IvanNieto5280/ME507/ChessRobotArm_FinalizedCode/Core/README.md

@mainpage Chess Robot Arm Documentation

@section authors Authors

Ivan Nieto

Reynaldo Farias

@section overview Project Overview

The purpose of the chess robot arm was to be able to create an electromechanical system that could pick up chess pieces and be able to move them around a chess board by joystick manipulation of a user. 

\htmlonly
<a href="https://youtube.com/shorts/9AqLv6E1KCE" target="_blank">
  
</a>
<br>
<em>Click image to watch the chess robot demo video.</em>
\endhtmlonly

@section hardware Major Hardware

- Three Stepper motors

- Servo-based gripper

- Two Joysticks

- Emergency stop

@section software Software Implementation

-  Serial Perpherial Interface (SPI)

- Serial Wire Debug (SWD)

- Universal Synchronous Asynchronous Reciever-Transmitter (USART)

@section pcb PCB Design

<div align="left">
    
    <br>
    <em>Figure 1. PCB with connected wiring.</em>
</div>

@section wire Wire Harnessing

@section future Future Work
