IvanNieto5280/ME507/Chess Robot Arm Electronics Design Memorandum.pdf

Chess Robot Arm: Electronics Design

To: | Charlie Revfem, Department of Mechanical Engineering, Cal Poly SLO
crefvem@calpoly.edu
From: | Reynaldo Farias RF
Ivan Nieto | IN
Date: | 5/17/2026

This memorandum accompanies the electronics design submission for the Chess Robot Arm. Included with this submission are the following items:

### 1. Fusion 360 electronics design export (.f3z)

### 2. Detailed bill of materials (BOM) including:

o Reference Designators
o Quanty
o Manufacturer/vendor part numbers
o Supplier links

### 3. Mechanical assembly drawing showing PCB integraon into the overall design

### 4. Updated high-level wiring diagram

The Chess Robot Arm consists of a Xbox-type controller which contains two modes, selected by moving a switch on the PCB; One to manually move the arm with joyscks, and the other to have the robot autonomously play chess with the user using a Raspberry Pi camera system. The first mode is the main goal of the project, while the second mode is the reach goal.
Please refer to the aached documentaon for detailed design informaon, component sourcing, and wiring specificaons.
