IvanNieto5280/ME507/docs/BlockDiagram.jpg

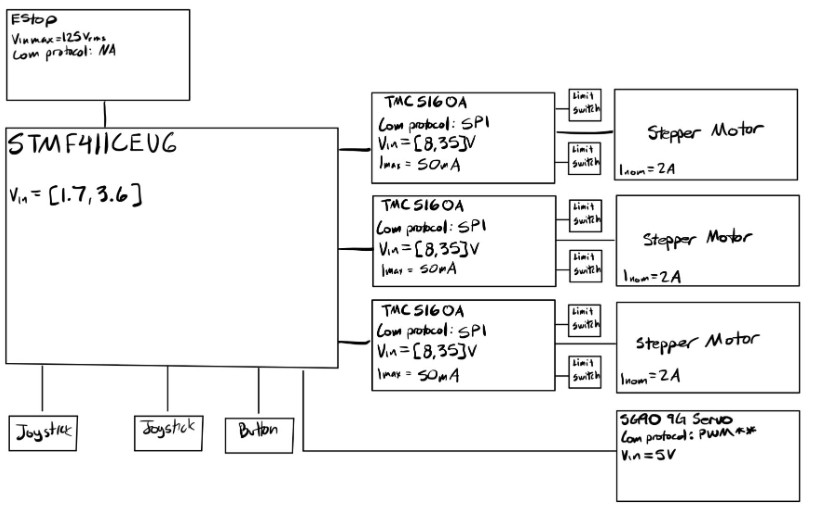
docs/BlockDiagram.jpg
