IvanNieto5280/ME507/docs/CR1.jpg

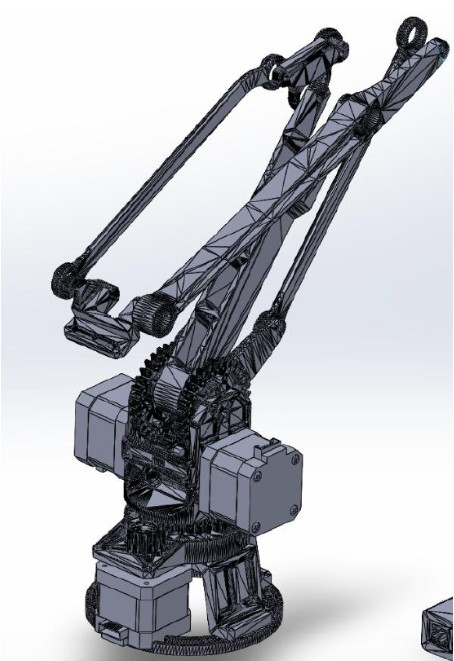
docs/CR1.jpg
