IvanNieto5280/ME507/docs/CR2.jpg

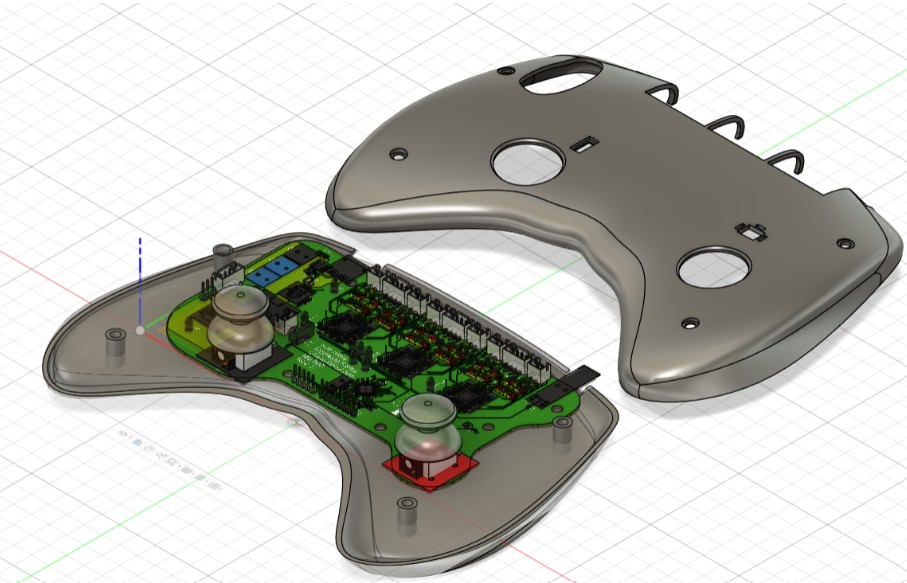
docs/CR2.jpg
