IvanNieto5280/ME507/docs/Rework.jpg

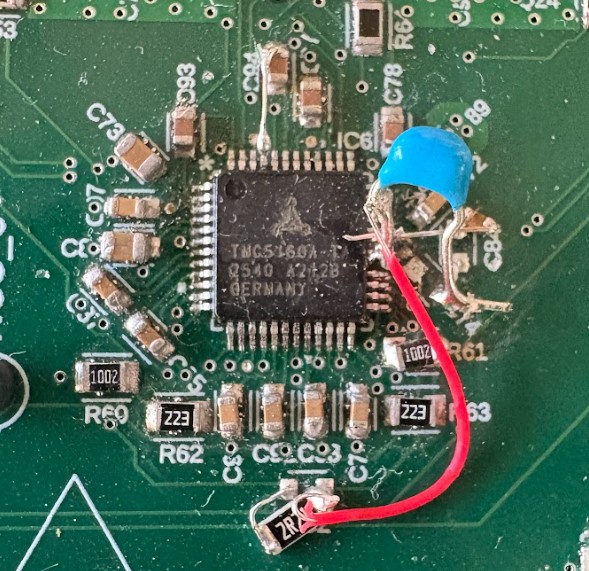
docs/Rework.jpg
