IvanNieto5280/ME507/Minimal MCU_ME507_Homework 3_BOM.pdf

Name | Minimal MCU_ME507_Homework 3 v11
Exported by | ivan.nieto5280@gmail.com
Time of Export | 4/19/2026 1:16 PM
Reference Designators | Quantity
| 1
C1, C2 | 2
C3, C9 | 2
C4, C5, C6, C7, C8, C10, C15 | 7
C12 | 1
C13 | 1
C14 | 1
C17, C18 | 2
CR1 | 1
D1 | 1
IC1 | 1
IC2 | 1
IC3 | 1
JP1 | 1
L1 | 1
Q1 | 1
R1 | 1
R2, R8 | 2
R3, R4 | 2
R5 | 1
R6 | 1
U$2 | 1
U$3 | 1
X1 | 1
Z1 | 1

Description
Board
Capacitor - Generic
Capacitor - Generic
Capacitor - Generic
Capacitor - Generic
Capacitor - Generic

Capacitor - Generic

Green LED - Generic

Pin Header

Resistor Fixed - Generic
Resistor Fixed - Generic
Resistor Fixed - Generic
Resistor Fixed - Generic
Resistor Fixed - Generic

250 mW Rating on FR-4 or FR-5 Board; Zener Breakdown Voltage Range - 2.4 V to 75 V; Package Designed for Optimal Automated Board Assembly; Small Package Size for High Density Applications; ESD Rating of Class 3 (>16 KV) per Human Body Model; Mechanical Characteristics:; CASE: Void-free, transfer-molded, thermosetting plastic case; FINISH: Corrosion resistant finish, easily solderable; MAXIMUM CASE TEMPERATURE FOR SOLDERING PURPOSES: 260C for 10 Seconds; POLARITY: Cathode indicated by polarity band; FLAMMAB

Package | Value | Manufacturer
Board
CAPC1608X85 | 10pF
CAPC1005X60 | 4.7uF
CAPC1005X60 | 0.1uF
CAPC3225X135 | 10uF
CAPC2012X110 | 10nF
PCAP_SVP_E7_PAN-L | 390uF
CAPC1005X60 | 1uF
DPAK_Q04FN-M3_VIS | VS-50WQ04FN-M3DPAK_Q04FN-M3_VIS
LEDC3216X75N_FLAT-G | CHIP-FLAT-G_1206
QFN50P700X700X60-49T559 | STM32F411CEU6
DDA8_3P1X2P4-L | TPS5450DDARDDA8_3P1X2P4-L
FP-NCP164CSN330T1G_OSI | NCP164CSN330T1GFP-NCP164CSN330T1G_OSI
1X08 | PINHD-1X8
DR127 | DR127-100-RDR127
TRANS_TSM150P04LCS_RLG | TSM150P04LCS_RLG | Taiwan Semiconductor
RESC1608X60 | 10k
RESC1608X60 | 1k
RESC1608X60 | 0.005
RESC2012X65 | 10k
RESC2012X65 | 3.16k
XTALRR488W43L1097T465H360 FOXSLF/080-20
PTS636SM43SMTRLFS | PTS636SM43SMTRLFSSWITCH
XT30PW-M | XT30PW-M
SOT96P237X111-3N | BZX84C15LT1G

Manufacturer Part Number Vendor Vendor Part Number Top/Bottom

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
