IvanNieto5280/ME507/Chess Robot Final BOM.xlsx

Reference Designators | Quantity | Manufacturer Part Number | Package | Value | Link
C1, C2 | 2 | GCM1885C2A300FA16D | CAPC1608X85 | 30pF | https://www.digikey.com/en/products/detail/murata-electronics/GCM1885C2A300FA16D/17845360
C3, C9, C23, C38, C49, C65, C76, C92 | 8 | TMK212AB7475KG-T | CAPC2012X110 | 4.7uF | https://www.digikey.com/en/products/detail/taiyo-yuden/TMK212AB7475KG-T/2714168
C4, C5, C6, C7, C8, C10, C16, C22, C32, C34, C35, C36, C37, C42, C43, C44, C45, C48, C59, C61, C62, C63, C64, C69, C70, C71, C72, C75, C86, C88, C89, C90, C91, C96, C97, C98 | 36 | C0603C104K5RACTU | CAPC1608X85 | 0.1uF | https://www.digikey.com/en/products/detail/kemet/C0603C104K5RACTU/1465594
C11 | 1 | C0603C104K5RACTU | CAPC1608X85 | 100nF | https://www.digikey.com/en/products/detail/kemet/C0603C104K5RACTU/1465594
C12 | 1 | CL32B106KMVNNWE | CAPC3225X135 | 10uF | https://www.digikey.com/en/products/detail/samsung-electro-mechanics/CL32B106KMVNNWE/7320558
C13 | 1 | CL21B103KBANNNC | CAPC2012X110 | 10nF | https://www.digikey.com/en/products/detail/samsung-electro-mechanics/CL21B103KBANNNC/3886673
C14 | 1 | 6SVPC390M | PCAP_SVP_E7_PAN-L | 390uF | https://www.digikey.com/en/products/detail/panasonic-industry/6SVPC390M/4204944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
C15 | 1 | GCM155R71H104KE02J | CAPC1005X60 | 0.1uF | https://www.digikey.com/en/products/detail/murata-electronics/GCM155R71H104KE02J/4903705
C17, C18 | 2 | GRM155Z71A105KE01D | CAPC1005X60 | 1uF | https://www.digikey.com/en/products/detail/murata-electronics/GRM155Z71A105KE01D/13905035
C19, C20, C46, C56, C73, C83 | 6 | CL21A475KAQNNNE | CAPC1608X85 | 4.7uF | https://www.digikey.com/en/products/detail/samsung-electro-mechanics/CL21A475KAQNNNE/3886902
C21, C24, C25, C39, C40, C47, C50, C51, C66, C67, C74, C77, C78, C93, C94 | 15 | KAM15BR71E474KT | CAPC1608X85 | 0.47uF | https://www.digikey.com/en/products/detail/kyocera-avx/KAM15BR71E474KT/27152850
C26, C27, C28, C29, C52, C53, C54, C55, C79, C80, C81, C82 | 12 | CL21B102KCANNNC | CAPC2012X110 | 1nF | https://www.digikey.com/en/products/detail/samsung-electro-mechanics/CL21B102KCANNNC/3886827
C30, C57, C84 | 3 | C0603C223K1RACTU | CAPC1608X85 | 22nF | https://www.digikey.com/en/products/detail/kemet/C0603C223K1RACTU/754738
C31, C58, C85 | 3 | EGXF101ELL201MK25S | CAPPRD500W65D1025H2500 | CAP_ALUM | https://www.digikey.com/en/products/detail/chemi-con/EGXF101ELL201MK25S/6204522
C33, C41, C60, C68, C87, C95 | 6 | C0603C222K4RECAUTO | CAPC1608X85 | 2.2nF | https://www.digikey.com/en/products/detail/kemet/C0603C222K4RECAUTO/8646528
C99 | 1 | 860040573004 | WCAP-ATUL_6.3X11(DXL) | WCAP-ATUL_6.3X11 | https://www.digikey.com/en/products/detail/w%C3%BCrth-elektronik/860040573004/5727450
D1, D3 | 2 | LTST-C150GKT | LEDC3216X75N_FLAT-G | CHIP-FLAT-G_1206 | https://www.digikey.com/en/products/detail/liteon/LTST-C150GKT/269216
D2 | 1 | VS-50WQ04FN-M3 | DPAK_Q04FN-M3_VIS-M | VS50WQ04FNM3 | https://www.digikey.com/en/products/detail/vishay-general-semiconductor-diodes-division/VS-50WQ04FN-M3/4934503
DGND, MISO, MOSI, NCS_1, NCS_2, NCS_3, PGND, SCK, VOGND | 9 | Popular Test Points | TP-KEYSTONE-COMPACT | TP_5005_COMPACT | https://www.digikey.com/en/products/detail/keystone-electronics/5000/255326?gclsrc=aw.ds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
FB1 | 1 | BLM18PG121SN1D | BEADC1608X95N | FBCHIP-0603(1608-METRIC) | https://www.digikey.com/en/products/detail/murata-electronics/BLM18PG121SN1D/584248
IC1 | 1 | STM32F411CEU6 | QFN50P700X700X60-49T559 | STM32F411CEU6 | https://www.digikey.com/en/products/detail/stmicroelectronics/STM32F411CEU6/4935720
IC2 | 1 | TPS54531DDAR | DDA8_3P1X2P4-L | TPS5450DDARDDA8_3P1X2P4-L | https://www.digikey.com/en/products/detail/texas-instruments/TPS54531DDAR/4162425
IC3 | 1 | NCP164CSN330T1G | FP-NCP164CSN330T1G_OSI | NCP164CSN330T1GFP-NCP164CSN330T1G_OSI | https://www.digikey.com/en/products/detail/onsemi/NCP164CSN330T1G/11592854
IC4, IC5, IC6 | 3 | TMC5160A-TA-T | 21-100582_ADI-L | TMC5160A-TA-T21-100582_ADI-L | https://www.digikey.com/en/products/detail/analog-devices-inc-maxim-integrated/TMC5160A-TA-T/11306900
J1, J4, J6, J9 | 4 | XH Connector Top Entry - 4POS | B4B-XH-A | B4B-XH-A | https://www.digikey.com/en/products/detail/jst-sales-america-inc/B4B-XH-A/1651047
J2, J3, J5, J7, J8, J10, J11 | 7 | B2B-XH-A | B2B-XH-A | B2B-XH-A | https://www.digikey.com/en/products/detail/jst-sales-america-inc/B2B-XH-A/1651045
Insert to above | 7 | XHP-2 |  |  | https://www.digikey.com/en/products/detail/jst-sales-america-inc/XHP-2/555485
JP1 | 1 | 61300311121 | 1X08 | PINHD-1X8 | https://www.digikey.com/en/products/detail/w%C3%BCrth-elektronik/61300311121/4846825
JS1, JS2 | 2 | 9032 | XDCR_COM-09032 | COM-09032 | https://www.digikey.com/en/products/detail/sparkfun-electronics/09032/6823623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
L1 | 1 | SRR1260-100M | DR127 | DR127-100-RDR127 | https://www.digikey.com/en/products/detail/bourns-inc/SRR1260-100M/1969954
PG | 1 | Test Pad | TP127R | TPSQTP127R | NA
Q1 | 1 | TSM150P04LCS RLG | TRANS_TSM150P04LCS_RLG | TSM150P04LCS_RLG | https://www.digikey.com/en/products/detail/taiwan-semiconductor-corporation/TSM150P04LCS-RLG/7360154
Q2, Q3, Q4, Q5, Q6, Q7, Q8, Q9, Q10, Q11, Q12, Q13, Q14, Q15, Q16, Q17, Q18, Q19, Q20, Q21, Q22, Q23, Q24, Q25 | 24 | RQ5L045BGTCL | SOT-346T | RQ5L045BG | https://www.digikey.com/en/products/detail/rohm-semiconductor/RQ5L045BGTCL/22602123
R1, R4, R9, R18, R30, R71 | 6 | RC0603FR-0710KL | RESC1608X60 | 10k | https://www.digikey.com/en/products/detail/yageo/RC0603FR-0710KL/726880
R2, R3 | 2 | ERJ-PA3J512V | RESC1608X60 | 5.1k | https://www.digikey.com/en/products/detail/panasonic-industry/ERJ-PA3J512V/5036073
R5, R19, R20, R41, R42, R60, R61 | 7 | RMCF0805FT10K0 | RESC2012X65 | 10k | https://www.digikey.com/en/products/detail/stackpole-electronics-inc/RMCF0805FT10K0/1760676
R6 | 1 | RC0603FR-073K16L | RESC2012X65 | 3.16k | https://www.digikey.com/en/products/detail/yageo/RC0603FR-073K16L/727124
R7 | 1 | RC0603FR-0747KL | RESC1608X60 | 47k | https://www.digikey.com/en/products/detail/yageo/RC0603FR-0747KL/727253
R8 | 1 | RC0603FR-07665RL | RESC1608X60 | 665 | https://www.digikey.com/en/products/detail/yageo/RC0603FR-07665RL/727349
R10, R33, R52 | 3 | RMCF1206FT2R21 | RESC1608X60 | 2.2 | https://www.digikey.com/en/products/detail/stackpole-electronics-inc/RMCF1206FT2R21/1758756
R11, R12, R13, R14, R23, R24, R25, R26, R34, R35, R36, R37, R45, R46, R47, R48, R53, R54, R55, R56, R64, R65, R66, R67 | 24 | CRCW080510R0FKEA | RESC2012X65 | 10 | https://www.digikey.sg/en/products/detail/vishay-dale/CRCW080510R0FKEA/1175409
R15, R27, R38, R49, R57, R68 | 6 | MFHA1206R1500FC | RESC3216X70 | 0.15 | https://www.digikey.com/en/products/detail/eaton-electronics-division/MFHA1206R1500FC/16713120
R16, R17, R28, R29, R39, R40, R50, R51, R58, R59, R69, R70 | 12 | RC0603FR-0747RL | RESC1608X60 | 47 | https://www.digikey.com/en/products/detail/yageo/RC0603FR-0747RL/727252
R21, R22, R43, R44, R62, R63 | 6 | RC0805JR-0722KL | RESC2012X65 | 22k | https://www.digikey.com/en/products/detail/yageo/RC0805JR-0722KL/728286
R31, R32 | 2 | ERA-6AEB472V | RESC1608X60 | 4.7k | https://www.digikey.com/en/products/detail/panasonic-industry/ERA-6AEB472V/1465765
S1 | 1 | DS01-254-L-01BE | DS-01 | DS01 | https://www.digikey.com/en/products/detail/same-sky-formerly-cui-devices/DS01-254-L-01BE/11310875
S2 | 1 | PB400OAQR1BLK | SW_PB400OAQR1BLK | PB400OAQR1BLK | https://www.digikey.com/en/products/detail/e-switch/PB400OAQR1BLK/8042727
S3 | 1 | B3U-1000P | B3U-1000P(M) | B3U-X000B3U-1000P(M)1000P(M) | https://www.digikey.com/en/products/detail/omron-electronics-inc-emc-div/B3U-1000P/1534338?gclsrc=aw.ds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
SERVO_PWM | 1 | 61300311121 | 1X03 | SERVOSG90-HDR | https://www.digikey.com/en/products/detail/w%C3%BCrth-elektronik/61300311121/4846825
U$1 | 1 | FC4STCBMF8.0 | XTALRR488W43L1097T465H360 | FOXSLF/080-20 | https://www.digikey.com/en/products/detail/fox-electronics/FC4STCBMF8-0/1024692
U$2 | 1 | 61300311121 | 1X05 | PINHD-1X05_1X05M | https://www.digikey.com/en/products/detail/w%C3%BCrth-elektronik/61300311121/4846825
U$3 | 1 | PTS636SM43SMTR LFS | PTS636SM43SMTRLFS | PTS636SM43SMTRLFSSWITCH | https://www.digikey.com/en/products/detail/c-k/PTS636SM43SMTR-LFS/10071723
X1 | 1 | XT30PW-M | XT30PW-M | XT30PW-M | https://www.amazon.com/XT30PW-Upgrade-Female-Connectors-Battery/dp/B0DM19KN2Y
Z1 | 1 | BZX84C15LT1G | SOT96P237X111-3N | BZX84C15LT1G | https://www.digikey.com/en/products/detail/onsemi/BZX84C15LT1G/918390
Stepper motor wires |  |  |  |  | https://www.amazon.com/Matugajp-0-2mm%C2%B2-Electrical-Extension-Stranded/dp/B0B943J4PG
Limit Switch Wires |  |  |  |  | https://www.amazon.com/AWG-Gauge-Electrical-Wire-Oxygen-Free/dp/B0FCM6L2DJ?sp_csd=d2lkZ2V0TmFtZT1zcF9hdGY
Limit Switches |  | D2F-L-D3 |  |  | https://www.digikey.com/en/products/detail/omron-electronics-inc-emc-div/D2F-L-D3/1811811
