IvanNieto5280/ME507/ChessRobotWiringDiagram.pdf

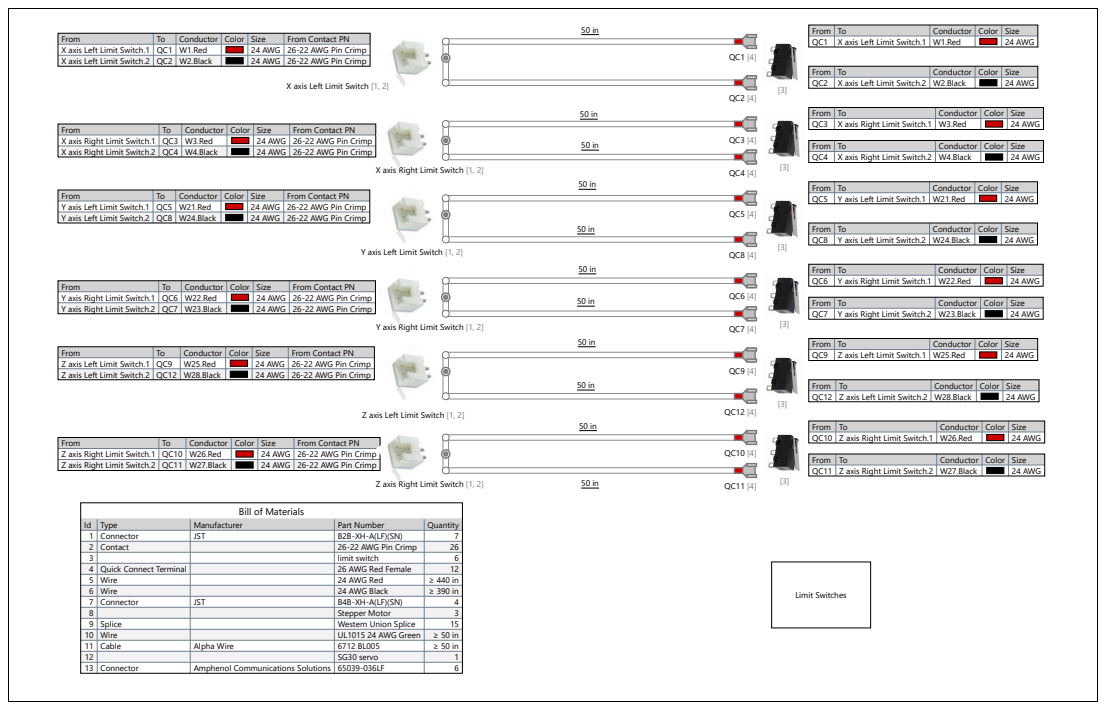
[picture p8: page 1]
Type; Manufacturer; Part Number; Quantity 1; Connector; JST; Contact; 26-22 AWG Pin Crimp; limit switch; Quick Connect Terminal; 26 AWG Red Female; Wire; 24 AWG Red; 24 AWG Black; Stepper Motor; Splice; Western Union Splice; UL1015 24 AWG Green; Cable; Alpha Wire; 12 SG30 servo; Amphenol Communications Solutions; From; Conductor; Color; Size; From Contact PN; X axis Left Limit Switch.1; W1.Red; 24 AWG; X axis Left Limit Switch.2; W2.Black; X axis Right Limit Switch.1; W3.Red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

-22 AWG Pin Crimp

X axis Left Limit Switch [1, 2]

X axis Right Limit Switch [1, 2]

Y axis Left Limit Switch [1, 2]

Y axis Right Limit Switch [1, 2]

Z axis Left Limit Switch [1, 2]

Z axis Right Limit Switch [1, 2]

Bill of Materials

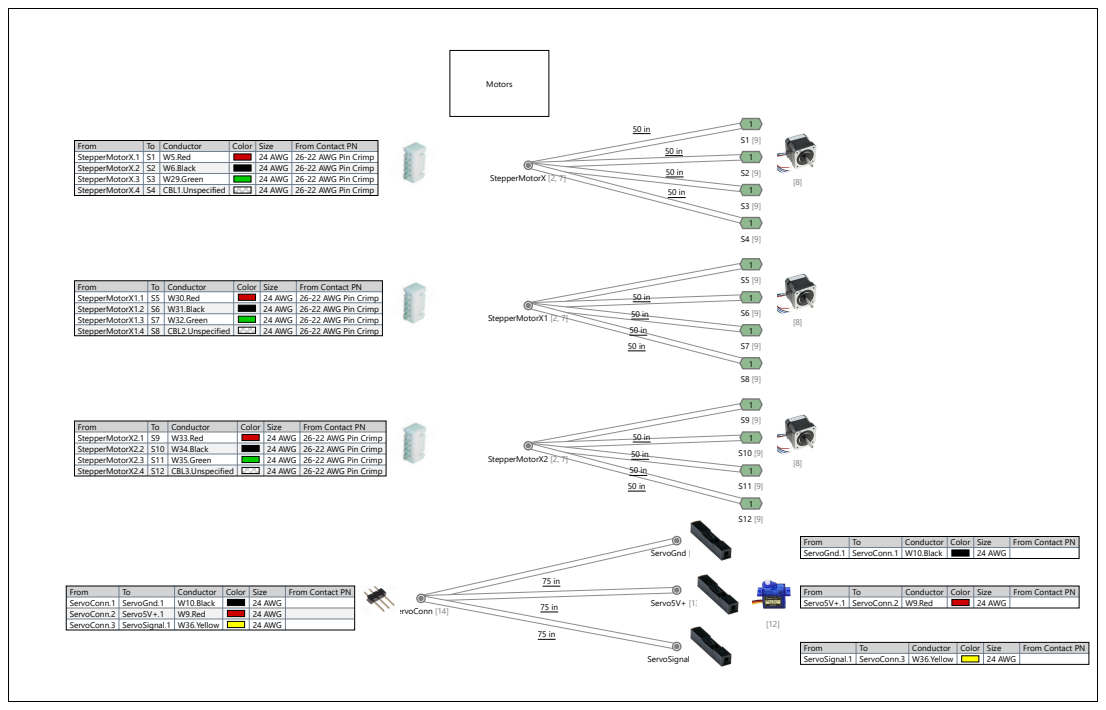
[picture p9: page 2]
From; Conductor; Color; Size; From Contact PN; StepperMotorX.1; W5.Red; 24 AWG; 26-22 AWG Pin Crimp; StepperMotorX.2; W6.Black; StepperMotorX.3; W29.Green; StepperMotorX.4; CBL1.Unspecified; StepperMotorX1.1; W30.Red; StepperMotorX1.2; W31.Black; StepperMotorX1.3; W32.Green; StepperMotorX1.4; CBL2.Unspecified; StepperMotorX2.1; W33.Red; StepperMotorX2.2; W34.Black; StepperMotorX2.3; W35.Green; StepperMotorX2.4; CBL3.Unspecified; ServoGnd.1; ServoConn.1; W10.Black; Servo5V+.1; ServoConn.2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

From | To | Conductor | Color | Size | From Contact PN
Raspberry Pi Communication.1 | SCA.1 | W7.Red | 24 AWG | 26-22 AWG Pin Crimp
Raspberry Pi Communication.2 | SCL.1 | W8.Black | 24 AWG | 26-22 AWG Pin Crimp
From | To | Conductor | Color | Size | From Contact PN
SCA.1 | Raspberry Pi Communication.1 | W7.Red | 24 AWG
From | To | Conductor | Color | Size | From Contact PN
SCL.1 | Raspberry Pi Communication.2 | W8.Black | | 24 AWG

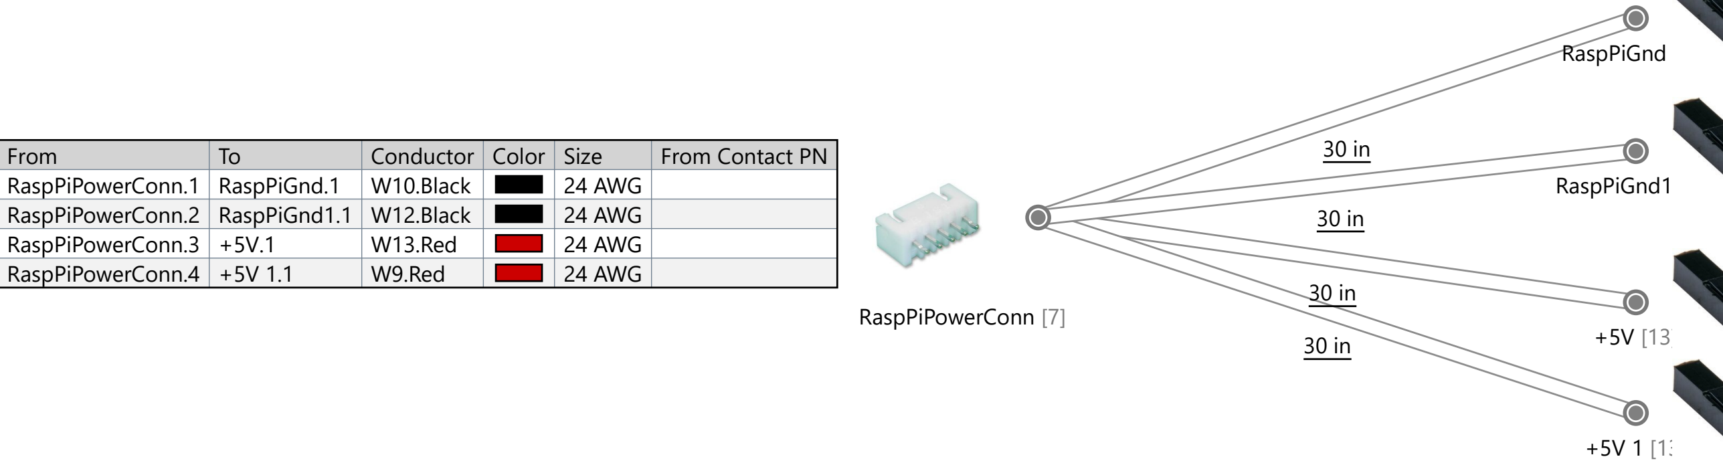
[picture p10: figure]
From; Conductor; Color; Size; From Contact PN; RaspPiPowerConn.1; RaspPiGnd.1; W10.Black; 24 AWG; RaspPiPowerConn.2; RaspPiGnd1.1; W12.Black; RaspPiPowerConn.3; W13.Red; RaspPiPowerConn.4; W9.Red; RaspPiPowerConn [7]; RaspPiGnd [13]; RaspPiGnd1 [13]

From | To | Conductor | Color | Size | From Contact PN
RaspPiGnd.1 | RaspPiPowerConn.1 | W10.Black | | 24 AWG
From | To | Conductor | Color | Size | From Contact PN
RaspPiGnd1.1 | RaspPiPowerConn.2 | W12.Black | | 24 AWG
From | To | Conductor | Color | Size | From Contact PN
+5V.1 | RaspPiPowerConn.3 | W13.Red | | 24 AWG
From | To | Conductor | Color | Size | From Contact PN
+5V 1.1 | RaspPiPowerConn.4 | W9.Red | | 24 AWG

Raspberry Pi Communication [1, 2]

SCA [13]

SCL [13]

### 30 in

### 30 in

Raspberry Pi
