IvanNieto5280/ME507/ChessRobotArm_FinalizedCode/Core/Src/main.c

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
/* Includes ------------------------------------------------------------------*/
#include "main.h"

/* USER CODE BEGIN Includes */
#include "fsm.h"
#include "Joystick.h"
#include "StepperMotorDriver.h"
#include "fsm.h"
#include <stdio.h>
#include <string.h>
/* USER CODE END Includes */

/* USER CODE BEGIN PD */



uint16_t adc_value = 0;
uint8_t rx_data;
GPIO_PinState lastState = GPIO_PIN_RESET;
volatile uint8_t userButtonPressed = 0;
volatile uint8_t eStopPressed = 0;
volatile uint16_t joy_x1 = 0;
volatile uint16_t joy_y1 = 0;
volatile uint16_t joy_x2 = 0;
volatile uint8_t adc_request = 0;
volatile uint8_t tmc_debug_request = 0;



/* USER CODE END PD */

ADC_HandleTypeDef hadc1;

I2C_HandleTypeDef hi2c1;

SPI_HandleTypeDef hspi2;
DMA_HandleTypeDef hdma_spi2_tx;

TIM_HandleTypeDef htim3;

UART_HandleTypeDef huart2;

/* USER CODE BEGIN PV */

stepper_motor_driver_t motor1;
stepper_motor_driver_t motor2;
stepper_motor_driver_t motor3;


uint8_t TX_Buffer [] = "Testing" ; // DATA to send

/* USER CODE END PV */

void SystemClock_Config(void);
static void MX_GPIO_Init(void);
static void MX_DMA_Init(void);
static void MX_ADC1_Init(void);
static void MX_I2C1_Init(void);
static void MX_SPI2_Init(void);
static void MX_TIM3_Init(void);
static void MX_USART2_UART_Init(void);
/**
  * @brief  The application entry point.
  * @retval int
  */
int main(void)
{

  /* USER CODE BEGIN 1 */

	// Initialize the Motor Structs
	motor1.hspi = &hspi2;
	motor1.Diag0_Port = Diag0_1_GPIO_Port;
	motor1.Diag0_Pin = Diag0_1_Pin;
	motor1.Diag1_Port = Diag1_1_GPIO_Port;
	motor1.Diag1_Pin = Diag1_1_Pin;
	motor1.NCS_Port = NCS_1_GPIO_Port;
	motor1.NCS_Pin = NCS_1_Pin;

	motor2.hspi = &hspi2;
	motor2.Diag0_Port = Diag0_2_GPIO_Port;
	motor2.Diag0_Pin = Diag0_2_Pin;
	motor2.Diag1_Port = Diag1_2_GPIO_Port;
	motor2.Diag1_Pin = Diag1_2_Pin;
	motor2.NCS_Port = NCS_2_GPIO_Port;
	motor2.NCS_Pin = NCS_2_Pin;

	motor3.hspi = &hspi2;
	motor3.Diag0_Port = Diag0_3_GPIO_Port;
	motor3.Diag0_Pin = Diag0_3_Pin;
	motor3.Diag1_Port = Diag1_3_GPIO_Port;
	motor3.Diag1_Pin = Diag1_3_Pin;
	motor3.NCS_Port = NCS_3_GPIO_Port;
	motor3.NCS_Pin = NCS_3_Pin;


  /* USER CODE END 1 */

  /* MCU Configuration--------------------------------------------------------*/

  /* Reset of all peripherals, Initializes the Flash interface and the Systick. */
  HAL_Init();

  /* Configure the system clock */
  SystemClock_Config();

  /* Initialize all configured peripherals */
  MX_GPIO_Init();
  MX_DMA_Init();
  MX_ADC1_Init();
  MX_I2C1_Init();
  MX_SPI2_Init();
  MX_TIM3_Init();
  MX_USART2_UART_Init();
  /* USER CODE BEGIN 2 */

  // Initialize PB5 as NCS

//  GPIO_InitTypeDef GPIO_InitStruct = {0};
//
//  __HAL_RCC_GPIOB_CLK_ENABLE();
//
//  GPIO_InitStruct.Pin = GPIO_PIN_5;
//  GPIO_InitStruct.Mode = GPIO_MODE_OUTPUT_PP;
//  GPIO_InitStruct.Pull = GPIO_NOPULL;
//  GPIO_InitStruct.Speed = GPIO_SPEED_FREQ_HIGH;
//
//  HAL_GPIO_Init(GPIOB, &GPIO_InitStruct);

  // Set NCS to high initially
  //HAL_GPIO_WritePin(GPIOB, GPIO_PIN_5, GPIO_PIN_SET);

  //Send SPI to initialize motor
  TMC_Init(&motor1);
  TMC_Init(&motor2);
  TMC_Init(&motor3);

  // Arm UART to recieve rx in interrupt mode
  HAL_UART_Receive_IT(&huart2, &rx_data, 1);

  //Servo Motor PWM Start
  HAL_TIM_PWM_Start_IT(&htim3, TIM_CHANNEL_3);
  // Set Servo Claw to open
  //__HAL_TIM_SET_COMPARE(&htim3, TIM_CHANNEL_3, SERVO_OPEN);

  /* USER CODE END 2 */

  /* Infinite loop */
  /* USER CODE BEGIN WHILE */

  char test[] = "UART OK\r\n";
  HAL_UART_Transmit(&huart2, (uint8_t*)test, strlen(test), HAL_MAX_DELAY);

  while (1)
  {
	  FSM_Update(&fsm);

//	    if (tmc_debug_request)
//	    {
//	        tmc_debug_request = 0;
//
//	        TMC_PrintDebug(&motor1);
//	    }



	  //JOYSTICK TEST CODE
	  // Read Joysticks
//	  uint16_t joy_x1 = Read_ADC_Channel(&hadc1, JOYSTICK1X);
//	  uint16_t joy_y1 = Read_ADC_Channel(&hadc1, JOYSTICK1Y);
//	  uint16_t joy_x2 = Read_ADC_Channel(&hadc1, JOYSTICK2X);
//	  uint16_t joy_y2 = Read_ADC_Channel(&hadc1, JOYSTICK2Y);
//
//	  char msg[64];
//	  sprintf(msg, "X1: %u  Y1: %u    X2: %u  Y2: %u\r\n",
//			  (4096-joy_x1), joy_y1, (4096-joy_x2), joy_y2);
//
//	  HAL_UART_Transmit(&huart2, (uint8_t*)msg, strlen(msg), 100);

//	  HAL_Delay(200);
//	  HAL_GPIO_TogglePin(GPIOB, GPIO_PIN_1);







	  // SPI TEST CODE
	  // Sending SPI Transfer in Blocking mode
	  //TMC_SPI_Send40(0xAD00003200, &motor2);
//	  TMC_MoveOneRotationLeft(&motor2);
//	  HAL_Delay(2500);
//	  TMC_SPI_Send40(packet(XTARGETW, 0), &motor2);
//	  HAL_Delay(2500);




	  //Test LED

//	    HAL_GPIO_TogglePin(GPIOB, GPIO_PIN_1);
//	    HAL_Delay(500);



//   // Test Crystal
//	    uint32_t sysclk = HAL_RCC_GetSysClockFreq();
//	    uint32_t hclk   = HAL_RCC_GetHCLKFreq();
//
//	    volatile uint32_t a = sysclk;
//	    volatile uint32_t b = hclk;

    /* USER CODE END WHILE */

    /* USER CODE BEGIN 3 */
  }
  /* USER CODE END 3 */
}

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
/* USER CODE BEGIN 4 */


void HAL_UART_RxCpltCallback(UART_HandleTypeDef *huart)
{
    if (huart->Instance == USART2)
    {
        //adc_request = 1;   // ask main loop to read ADC
   	 tmc_debug_request = 1;

        HAL_UART_Receive_IT(&huart2, &rx_data, 1); // re-arm UART RX
    }
}

void HAL_GPIO_EXTI_Callback(uint16_t GPIO_Pin)
{
    if (GPIO_Pin == User_Button_Pin)
    {
   	 userButtonPressed = 1;
    }

    if (GPIO_Pin == eStop_Pin)
    {
   	 eStopPressed = 1;
    }

}

/* USER CODE END 4 */
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
