IvanNieto5280/ME507/ChessRobotArm_FinalizedCode/Core/Inc/main.h

#define LED_Pin GPIO_PIN_1
#define LED_GPIO_Port GPIOB
#define eStop_Pin GPIO_PIN_2
#define eStop_GPIO_Port GPIOB
#define eStop_EXTI_IRQn EXTI2_IRQn
#define DRV_ENN_Pin GPIO_PIN_10
#define DRV_ENN_GPIO_Port GPIOB
#define Diag1_3_Pin GPIO_PIN_12
#define Diag1_3_GPIO_Port GPIOB
#define Diag0_3_Pin GPIO_PIN_8
#define Diag0_3_GPIO_Port GPIOA
#define Diag1_2_Pin GPIO_PIN_9
#define Diag1_2_GPIO_Port GPIOA
#define Diag0_2_Pin GPIO_PIN_10
#define Diag0_2_GPIO_Port GPIOA
#define Diag1_1_Pin GPIO_PIN_11
#define Diag1_1_GPIO_Port GPIOA
#define Diag0_1_Pin GPIO_PIN_12
#define Diag0_1_GPIO_Port GPIOA
#define NCS_3_Pin GPIO_PIN_15
#define NCS_3_GPIO_Port GPIOA
#define NCS_2_Pin GPIO_PIN_4
#define NCS_2_GPIO_Port GPIOB
#define NCS_1_Pin GPIO_PIN_5
#define NCS_1_GPIO_Port GPIOB
#define User_Button_Pin GPIO_PIN_8
#define User_Button_GPIO_Port GPIOB
#define User_Button_EXTI_IRQn EXTI9_5_IRQn
#define PI_or_JS_Pin GPIO_PIN_9
#define PI_or_JS_GPIO_Port GPIOB
