IvanNieto5280/ME507/(commit log)

2026-05-14 Update print statement from 'Hello' to 'Goodbye'
2026-05-16 Create 507_Chess Robot Arm PCB_Final.f3z
2026-06-01 Add StepperMotorDriver header file
2026-06-03 Added Code to manipulate motor with Joystick
    Added code to manipulate
2026-06-10 New Chess Robot Code with some motor validation
    Motor stuff added
2026-06-10 Add main.c for two-limit switch test functionality
2026-06-10 Add StepperMotorDriver.c for motor control functions
    This file implements the command control for stepper motors, including functions for setting velocity, acceleration, and handling reference switches.
