IvanNieto5280/ME507/(notices)

Notices in the files:
ChessRobotArm_FinalizedCode/Core/Src/main.c:
Copyright (c) 2026 STMicroelectronics.
All rights reserved.
This software is licensed under terms that can be found in the LICENSE file
