IvanNieto5280/ME507/ChessRobotArm_FinalizedCode/Core/photos/PCB_without_wires.JPG

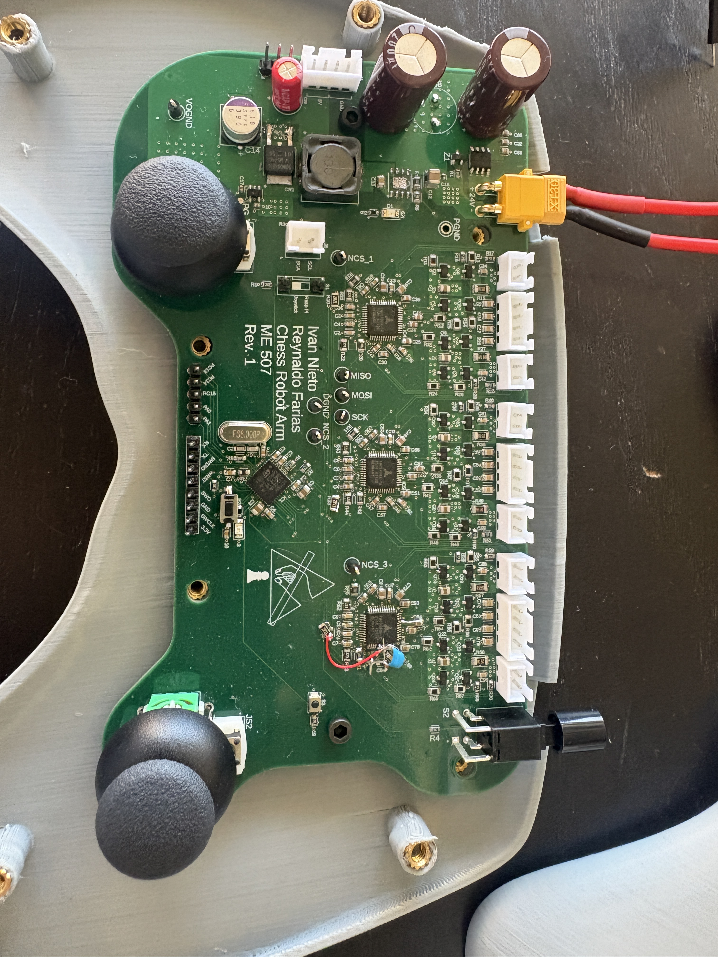
ChessRobotArm_FinalizedCode/Core/photos/PCB_without_wires.JPG
