IvanNieto5280/ME507/ChessRobotArm/Core/photos/ChessRobot.JPG

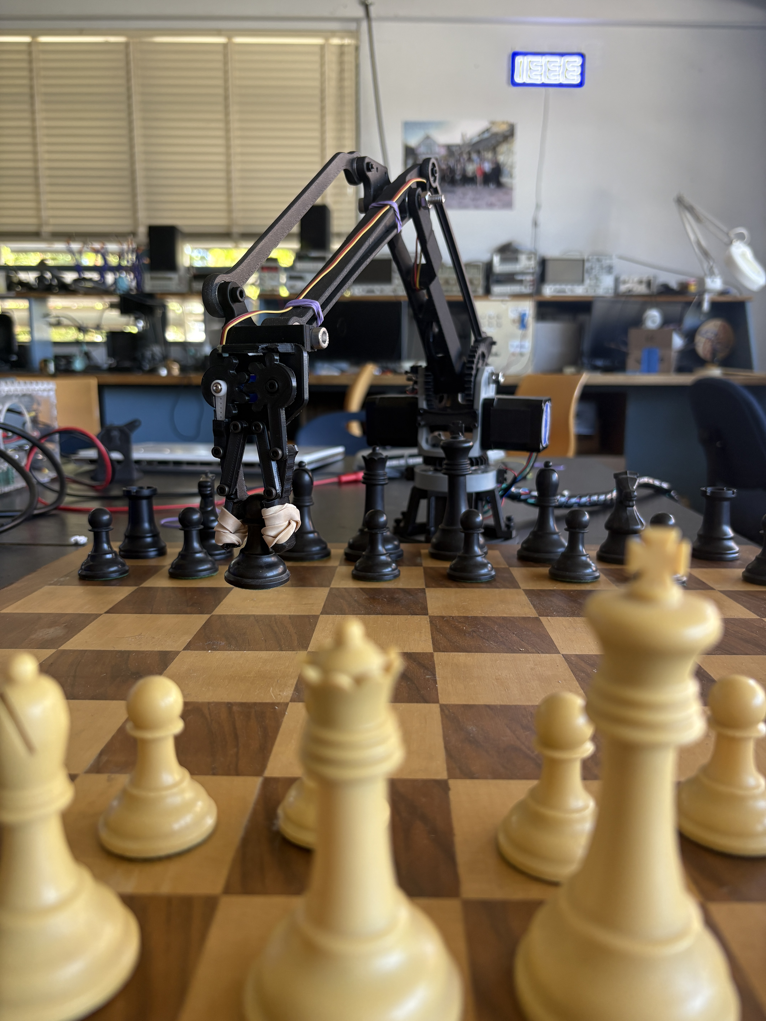
[picture p1: ChessRobotArm_FinalizedCode/Core/photos/ChessRobot.JPG]
ChessRobotArm/Core/photos/ChessRobot.JPG
