IvanNieto5280/ME507/ChessRobotArm/Core/photos/PCB_with_Wires.JPG

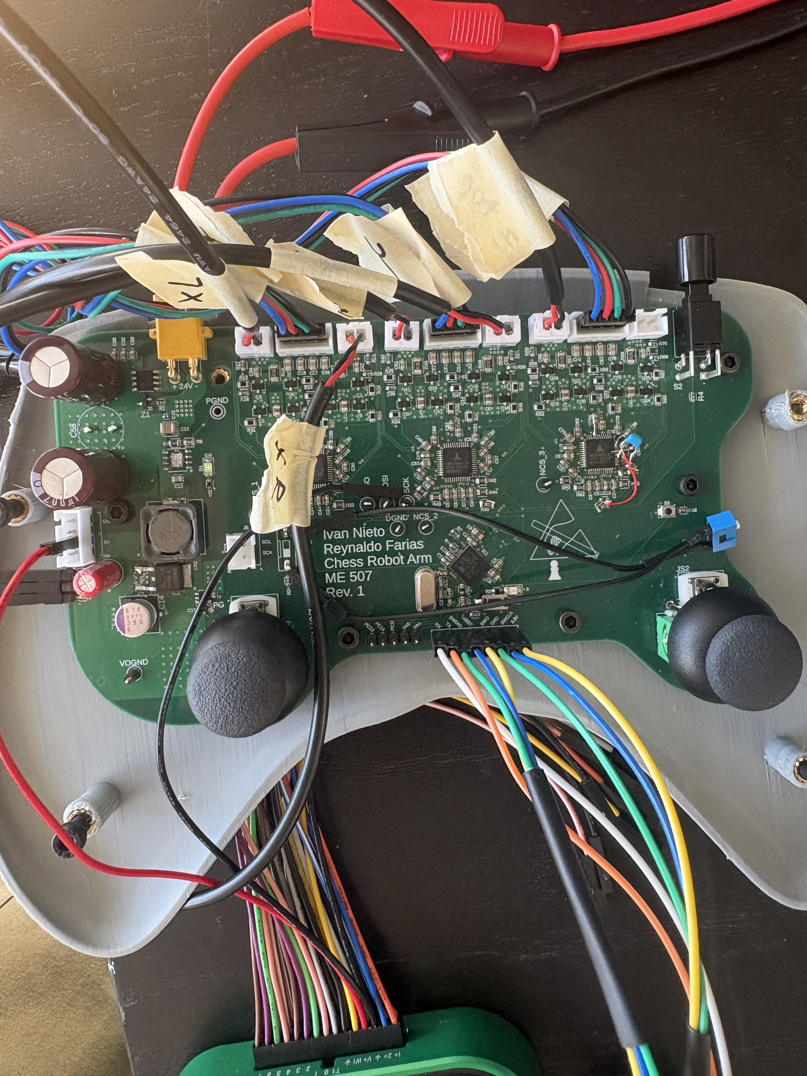
[picture p2: ChessRobotArm_FinalizedCode/Core/photos/PCB_with_Wires.JPG]
ChessRobotArm/Core/photos/PCB_with_Wires.JPG
